OpenMYR/ESP32-Stepper/README.md

# ESP32-Stepper
OpenMYR ESP32 controller board, stepper driver with A5984

Use with [ESP32-Motors](https://github.com/OpenMYR/ESP32-Motors) or write your own firmware.
