OpenMYR/ESP32-Stepper/(commit log)

2020-04-19 Open MYR ESP32 stepper driver with A5984 control board
    Board designed on KiCAD 5.
    Uses ESP32 KiCAD library from https://github.com/adamjvr/ESP32-kiCAD-Footprints
    [ESP32-Footprints.kicad_pcb, ESP32-Footprints.sch, ESP32.27.kicad_pcb, ESP32.27.sch]
2021-06-21 Moved bottom right mounting hole to be aligned with top right mounting hole. Updated silkscreen date code.
    [ESP32.27.kicad_pcb]
