OpenMYR/ESP32-Stepper/(notices)

Notices in the files:
ESP32.27.kicad_pcb:
Copyright Open MYR, LLC 2020.
Licensed under CERN OHL v.1.2 or later
